KoljaWindeler/CHIP_JKW_HDMI/hdmi-cable_318-51309.bmp

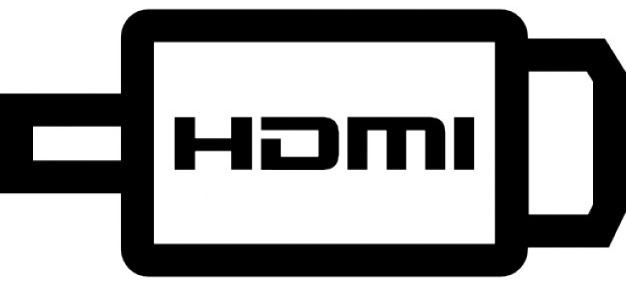
hdmi-cable_318-51309.bmp
