KoljaWindeler/CHIP_JKW_HDMI/schematics/v3_audio/jkw_hdmi_v3.brd

## EAGLE design schematics/v3_audio/jkw_hdmi_v3.brd (2016-08-16)

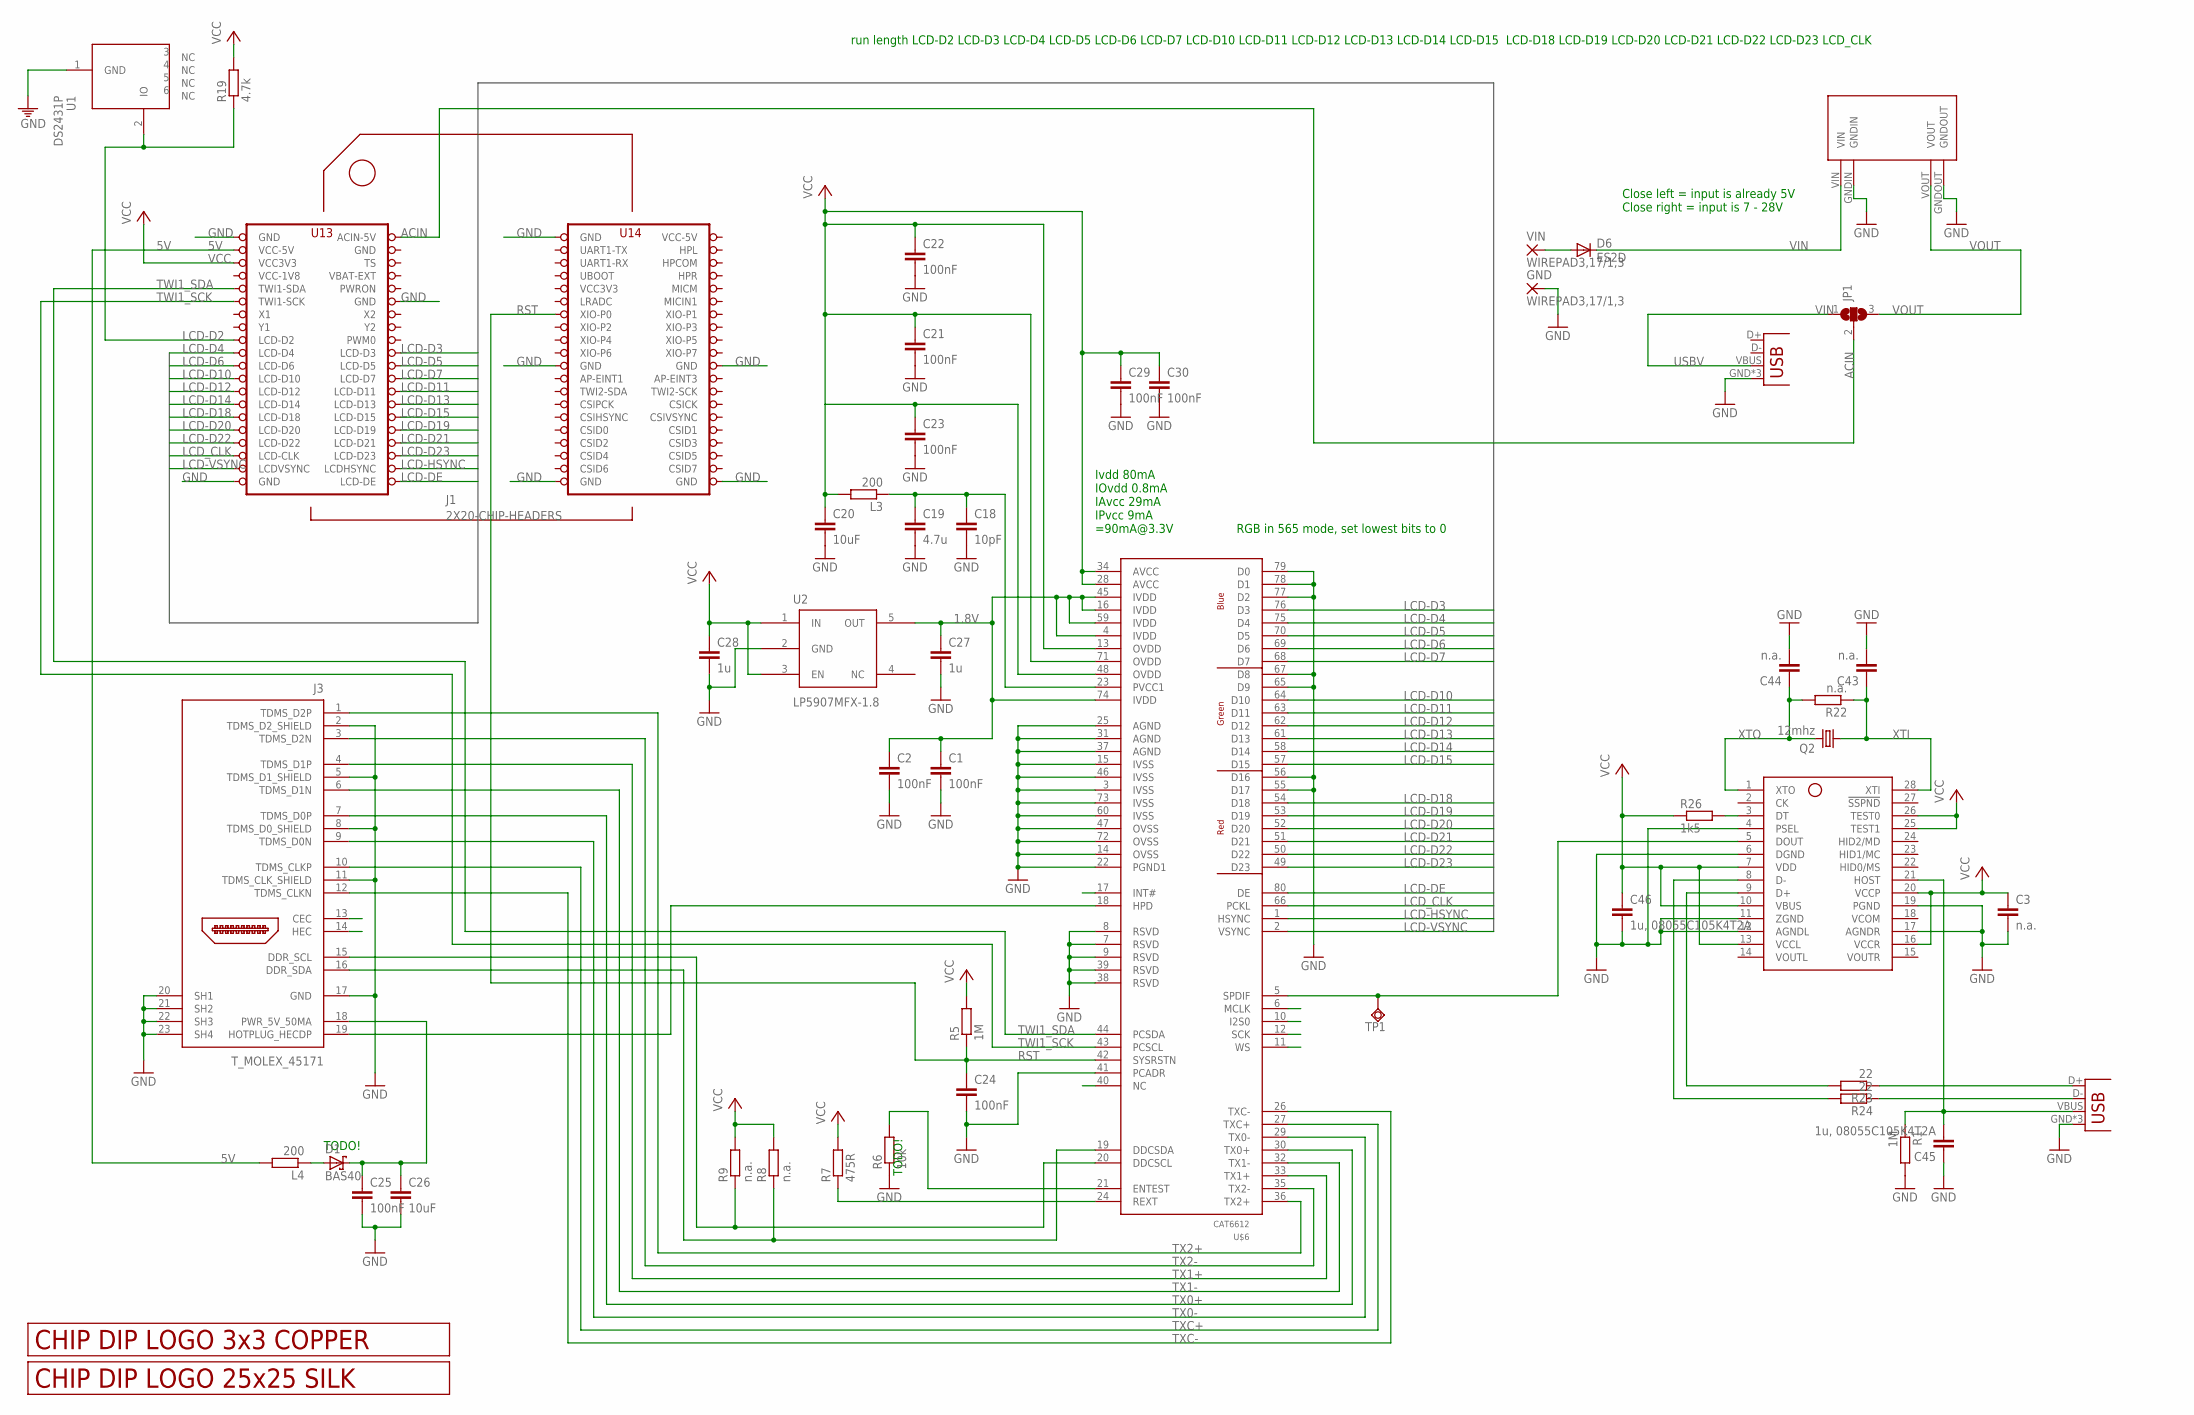
[picture p2: schematic jkw_hdmi_v3.sch]

Parts:
AUDIO_USB: USBUSB-MICROB-SMT-DIP; USB-MICROB-SMT-DIP
C1, C2, C21, C22, C23, C24, C25, C29, C30: 100nF; C0805
C3, C43, C44: n.a.; C0805
C18: 10pF; C0805
C19: 4.7u; C0805
C20, C26: 10uF; C0805
C27, C28: 1u; C0805
C45, C46: 1u, 08055C105K4T2A; C0805
D1: BAS40; SOT23
D6: ES2D; SMB
GND: WIREPAD3,17/1,3; 3,17/1,3
J1: 2X20-CHIP-HEADERS; 2X20CHIP_SM
J3: T_MOLEX_45171
JP1: SJ2W; SJ_2
L3, L4: 200; R0805
POWER_USB: USBUSB-MICROB-SMT-DIP; USB-MICROB-SMT-DIP
Q2: 12mhz; HC49UP
R1: 1M; M0805
R5: 1M; R0805
R6: 10k; R0805
R7: 475R; R0805
R8, R9: n.a.; R0805
R19: 4.7k; R0805
R22: n.a.; M0805
R23, R24: 22; M0805
R26: 1k5; M0805
TP1: TPSQTP12SQ; TP12SQ
U1: DS2431P; TSOC6
U2: LP5907MFX-1.8; SOT23-5
U$1: LOGO_25X25_SILK
U$4: LOGO_3X3_COPPER
U$5: PCM2704; SSOT28
U$6: CAT6612; LQFP-80
U$9: MP1584EN_FRAMELESS
VIN: WIREPAD3,17/1,3; 3,17/1,3

Connections:
1.8V: C1.1, C2.1, C27.1, U2.5 (OUT), U$6.4 (IVDD), U$6.16 (IVDD), U$6.45 (IVDD), U$6.59 (IVDD), U$6.74 (IVDD)
5V: J1.VCC5V@0 (VCC-5V), L4.2
ACIN: J1.CHG-IN (ACIN-5V), JP1.2
GND: AUDIO_USB.GND, AUDIO_USB.MT1 (GND), AUDIO_USB.MT2 (GND), C1.2, C2.2, C3.2, C18.2, C19.2, C20.2, C21.2, C22.2, C23.2, C24.2, C25.2, C26.2, C27.2, C28.2, C29.2, C30.2, C43.2, C44.2, C45.1, C46.2, GND.1, J1.GND@1 (GND), J1.GND@2 (GND), J1.GND@3 (GND), J1.GND@4 (GND), J1.GND@5 (GND), J1.GND@6 (GND), J1.GND@7 (GND), J1.GND@8 (GND), J1.GND@10 (GND), J3.2 (TDMS_D2_SHIELD), J3.5 (TDMS_D1_SHIELD), J3.8 (TDMS_D0_SHIELD), J3.11 (TDMS_CLK_SHIELD), J3.17 (GND), J3.20 (SH1), J3.21 (SH2), J3.22 (SH3), J3.23 (SH4), POWER_USB.GND, POWER_USB.MT1 (GND), POWER_USB.MT2 (GND), R1.2, R6.1, U1.1 (GND), U2.2 (GND), U$5.4 (PSEL), U$5.6 (DGND), U$5.11 (ZGND), U$5.12 (AGNDL), U$5.17 (AGNDR), U$5.19 (PGND), U$6.3 (IVSS), U$6.7 (RSVD), U$6.8 (RSVD), U$6.9 (RSVD), U$6.14 (OVSS), U$6.15 (IVSS), U$6.22 (PGND1), U$6.25 (AGND), U$6.31 (AGND), U$6.37 (AGND), U$6.38 (RSVD), U$6.39 (RSVD), U$6.41 (PCADR), U$6.46 (IVSS), U$6.47 (OVSS), U$6.55 (D17), U$6.56 (D16), U$6.60 (IVSS), U$6.65 (D9), U$6.67 (D8), U$6.72 (OVSS), U$6.73 (IVSS), U$6.77 (D2), U$6.78 (D1), U$6.79 (D0), U$9.GNDIN, U$9.GNDOUT
LCD-D2: J1.LCD-D2, R19.1, U1.2 (IO)
LCD-D3: J1.LCD-D3, U$6.76 (D3)
LCD-D4: J1.LCD-D4, U$6.75 (D4)
LCD-D5: J1.LCD-D5, U$6.70 (D5)
LCD-D6: J1.LCD-D6, U$6.69 (D6)
LCD-D7: J1.LCD-D7, U$6.68 (D7)
LCD-D10: J1.LCD-D10, U$6.64 (D10)
LCD-D11: J1.LCD-D11, U$6.63 (D11)
LCD-D12: J1.LCD-D12, U$6.62 (D12)
LCD-D13: J1.LCD-D13, U$6.61 (D13)
LCD-D14: J1.LCD-D14, U$6.58 (D14)
LCD-D15: J1.LCD-D15, U$6.57 (D15)
LCD-D18: J1.LCD-D18, U$6.54 (D18)
LCD-D19: J1.LCD-D19, U$6.53 (D19)
LCD-D20: J1.LCD-D20, U$6.52 (D20)
LCD-D21: J1.LCD-D21, U$6.51 (D21)
LCD-D22: J1.LCD-D22, U$6.50 (D22)
LCD-D23: J1.LCD-D23, U$6.49 (D23)
LCD-DE: J1.LCD-DE, U$6.80 (DE)
LCD-HSYNC: J1.LCD-HSYNC (LCDHSYNC), U$6.1 (HSYNC)
LCD-VSYNC: J1.LCD-VSYNC (LCDVSYNC), U$6.2 (VSYNC)
LCD_CLK: J1.LCD-CLK, U$6.66 (PCKL)
unnamed: J3.19 (HOTPLUG_HECDP), U$6.18 (HPD)
unnamed: C18.1, C19.1, L3.1, U$6.23 (PVCC1)
unnamed: J3.16 (DDR_SDA), R8.1, U$6.19 (DDCSDA)
unnamed: J3.15 (DDR_SCL), R9.1, U$6.20 (DDCSCL)
unnamed: R6.2, U$6.21 (ENTEST)
unnamed: R7.1, U$6.24 (REXT)
unnamed: TP1.TP, U$5.5 (DOUT), U$6.5 (SPDIF)
unnamed: D1.1 (A), L4.1
unnamed: C25.1, C26.1, D1.3 (C), J3.18 (PWR_5V_50MA)
unnamed: R23.2, U$5.9 (D+)
unnamed: AUDIO_USB.D+, R23.1
unnamed: R24.2, U$5.8 (D-)
unnamed: AUDIO_USB.D-, R24.1
unnamed: D6.A, VIN.1
unnamed: R26.2, U$5.3 (DT)
RST: C24.1, J1.XIO-P0, R5.1, U$6.42 (SYSRSTN)
TWI1_SCK: J1.TWI1-SCK, U$6.43 (PCSCL)
TWI1_SDA: J1.TWI1-SDA, U$6.44 (PCSDA)
TX0+: J3.7 (TDMS_D0P), U$6.30 (TX0+)
TX0-: J3.9 (TDMS_D0N), U$6.29 (TX0-)
TX1+: J3.4 (TDMS_D1P), U$6.33 (TX1+)
TX1-: J3.6 (TDMS_D1N), U$6.32 (TX1-)
TX2+: J3.1 (TDMS_D2P), U$6.36 (TX2+)
TX2-: J3.3 (TDMS_D2N), U$6.35 (TX2-)
TXC+: J3.10 (TDMS_CLKP), U$6.27 (TXC+)
TXC-: J3.12 (TDMS_CLKN), U$6.26 (TXC-)
USBV: JP1.1, POWER_USB.VBUS
VCC: C3.1, C20.1, C21.1, C22.1, C23.1, C28.1, C29.1, C30.1, C46.1, J1.VCC3V3, L3.2, R5.2, R7.2, R8.2, R9.2, R19.2, R26.1, U2.1 (IN), U2.3 (EN), U$5.7 (VDD), U$5.10 (VBUS), U$5.13 (VCCL), U$5.16 (VCCR), U$5.20 (VCCP), U$5.25 (TEST1), U$5.26 (TEST0), U$6.13 (OVDD), U$6.28 (AVCC), U$6.34 (AVCC), U$6.48 (OVDD), U$6.71 (OVDD)
VCC2: AUDIO_USB.VBUS, C45.2, R1.1, U$5.21 (HOST)
VCC3V3: J1.VCC3V3@1 (VCC3V3)
VCC-1V8: J1.VCC1V8 (VCC-1V8)
VCC-5V: J1.VCC5V@1 (VCC-5V)
VCOM: U$5.18 (VCOM)
VIN: D6.C, U$9.VIN
VOUT: JP1.3, U$9.VOUT
XTI: C43.1, Q2.1, R22.1, U$5.28 (XTI)
XTO: C44.1, Q2.2, R22.2, U$5.1 (XTO)

Notes on the sheet:
Close left = input is already 5V Close right = input is 7 - 28V
RGB in 565 mode, set lowest bits to 0
TODO!
Ivdd 80mA IOvdd 0.8mA IAvcc 29mA IPvcc 9mA =90mA@3.3V
run length LCD-D2 LCD-D3 LCD-D4 LCD-D5 LCD-D6 LCD-D7 LCD-D10 LCD-D11 LCD-D12 LCD-D13 LCD-D14 LCD-D15 LCD-D18 LCD-D19 LCD-D20 LCD-D21 LCD-D22 LCD-D23 LCD_CLK

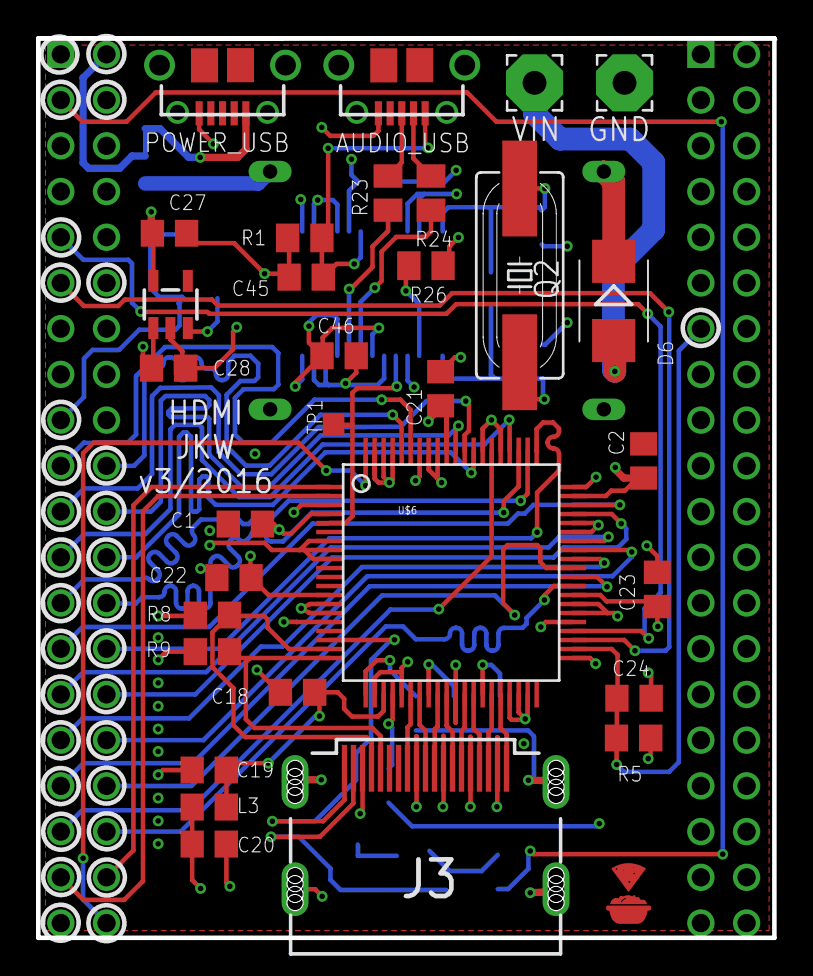
[picture p3: board jkw_hdmi_v3.brd from above]

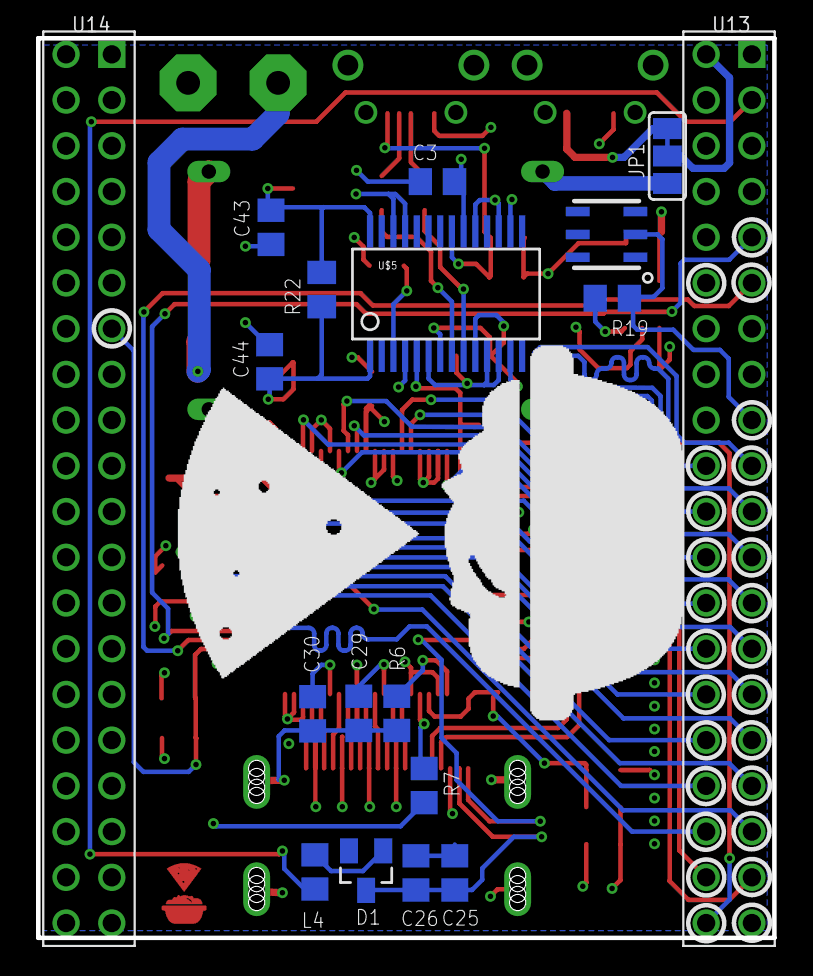
[picture p4: board jkw_hdmi_v3.brd from below]

Board: 4 copper layers, 40.9 x 50.0 mm, 51 parts (17 on the bottom side), 59 nets.
