KoljaWindeler/CHIP_JKW_HDMI/(commit log)

2016-07-11 layout 1
    [jkw_hdmi.brd, jkw_hdmi.sch]
2016-07-11 improved silk
    [jkw_hdmi.brd, jkw_hdmi.sch]
2016-07-12 added gerber and ordered design
    [jkw_hdmi.GBL, jkw_hdmi.GBO, jkw_hdmi.GBP, jkw_hdmi.GBS, jkw_hdmi.GTL, jkw_hdmi.GTO, jkw_hdmi.GTP, jkw_hdmi.GTS]
2016-07-21 added version with minimum drill
    [jkw_hdmi_micro_drill.brd, jkw_hdmi_micro_drill.sch]
2016-07-22 added estimation for quote
    [jkw_hdmi_micro_drill.csv, quotation_assumtions.xlsx]
2016-07-22 hdmi direct routing
    [jkw_hdmi_v2.brd, jkw_hdmi_v2.sch, quotation_v100.xlsx]
2016-07-22 removed old quotation
    [quotation_v100.xlsx]
2016-07-24 added v2 with DCDC
    [jkw_hdmi_v2.brd, jkw_hdmi_v2.sch]
2016-07-27 new board with audio
    [jkw_hdmi_v2.brd, jkw_hdmi_v2.sch]
2016-07-27 routing v1 done
    [jkw_hdmi_v2.GBL, jkw_hdmi_v2.GBO, jkw_hdmi_v2.GBP, jkw_hdmi_v2.GBS, jkw_hdmi_v2.GTL, jkw_hdmi_v2.GTO, jkw_hdmi_v2.GTP, jkw_hdmi_v2.GTS]
2016-07-28 removed temp files
    [jkw_hdmi_v2.GBL, jkw_hdmi_v2.GBO, jkw_hdmi_v2.GBP, jkw_hdmi_v2.GBS, jkw_hdmi_v2.GTL, jkw_hdmi_v2.GTO, jkw_hdmi_v2.GTP, jkw_hdmi_v2.GTS]
2016-07-28 updated routing for LCD length matching
    [jkw_hdmi_v3.brd, jkw_hdmi_v3.sch]
2016-07-28 added quotation
    [jkw_hdmi_v3.csv, quotation_assumtions_v3.xlsx]
2016-07-28 added frame
    [jkw_hdmi_v3.sch]
2016-07-28 added solder help
    [jkw_hdmi_v3.brd]
2016-07-28 minor fixes
    [jkw_hdmi_v3.brd, jkw_hdmi_v3.sch]
2016-07-29 gerber v3
    [jkw_hdmi_micro_drill.csv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]
2016-08-20 added images
    [quotation_assumtions_v3.xlsx]
2016-08-31 added programming guide
    [quotation_assumtions_v3.xlsx]
2016-09-02 added driver code
2016-09-03 added driver v2 code
2016-09-04 next driver version
2016-09-04 Freaking driver works./test !
